GeraAG/Quadron/README.md

# Quadron
The goal of the project was to design a quadrocopter based from technical task. We needed to think of a way to stabilize it, choose a way of communication, choose parts, design schematic and PCB layout.
